CarlosVieira99/Pikasso-Project/README.md

# Pikasso-Project
Bachelor Project with a final classification of 19 (scale of 0 - 20). Drawing and writing machine, controlled via Wi-Fi, with a graphical interface on the computer. Developed with C and Python.
