CarlosVieira99/Pikasso-Project/Datasheets/Stepper Table.jpg

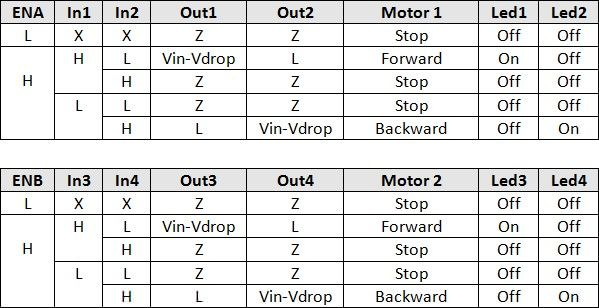
Datasheets/Stepper Table.jpg
