CarlosVieira99/Pikasso-Project/Mechanical Structure/Peças 3D.png

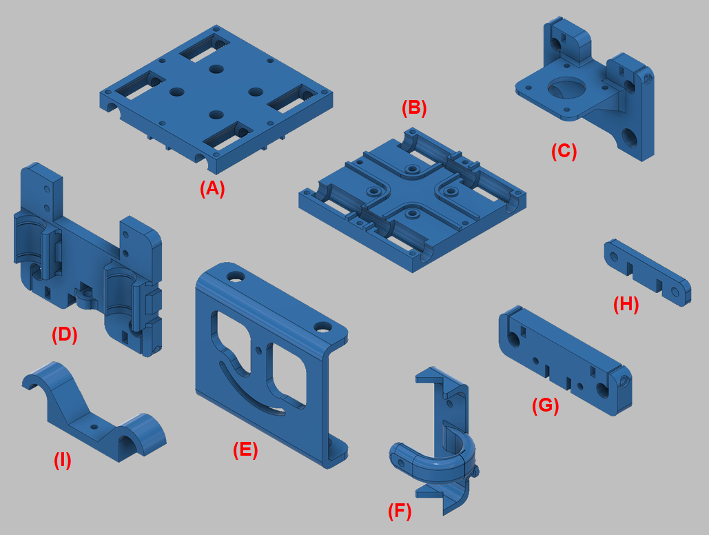
Mechanical Structure/Peças 3D.png
