CarlosVieira99/Pikasso-Project/Mechanical Structure/Projeto final.png

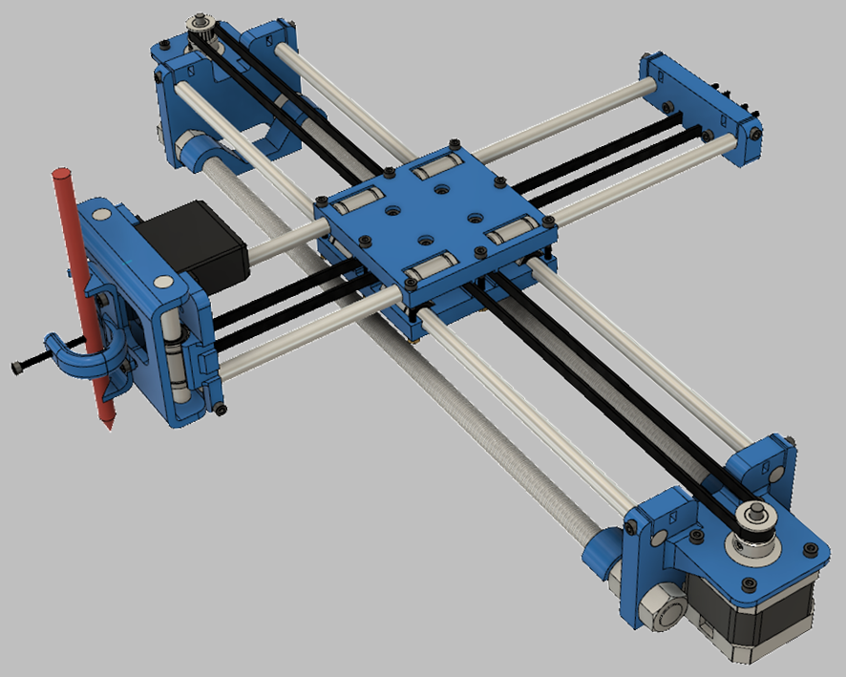
Mechanical Structure/Projeto final.png
