CarlosVieira99/Pikasso-Project/PCB Files/imagens/Vista_Baixo_RayTracing.png

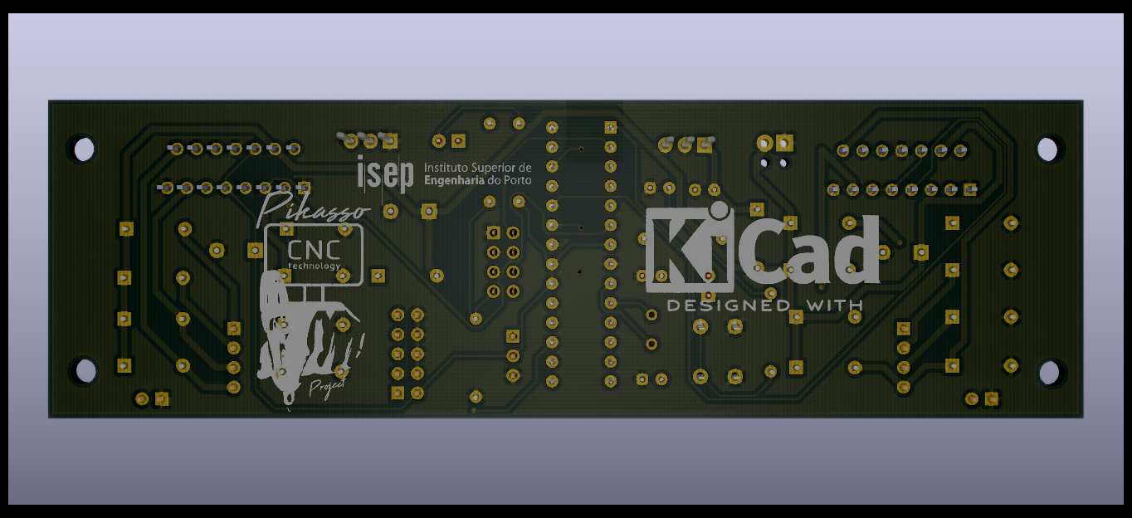
PCB Files/imagens/Vista_Baixo_RayTracing.png
