CarlosVieira99/Pikasso-Project/PCB Files/imagens/Vista_Cima_RayTracing.png

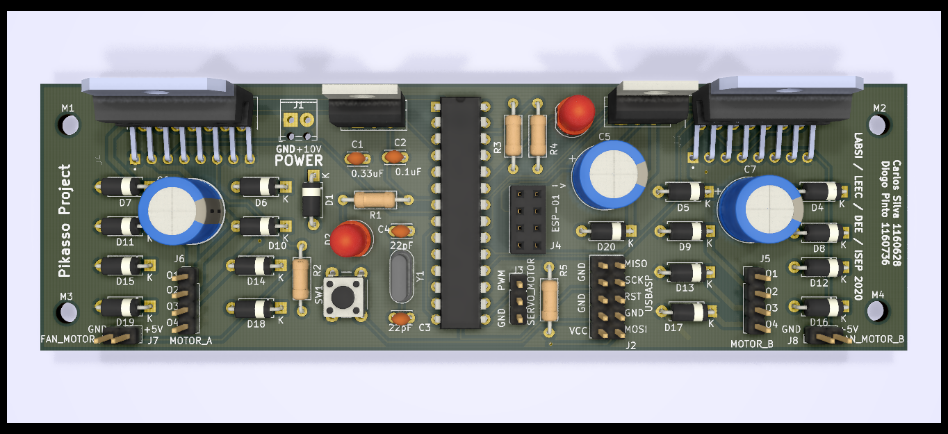
PCB Files/imagens/Vista_Cima_RayTracing.png
