CarlosVieira99/Pikasso-Project/PCB Files/imagens/Vista_Media_RayTracing.png

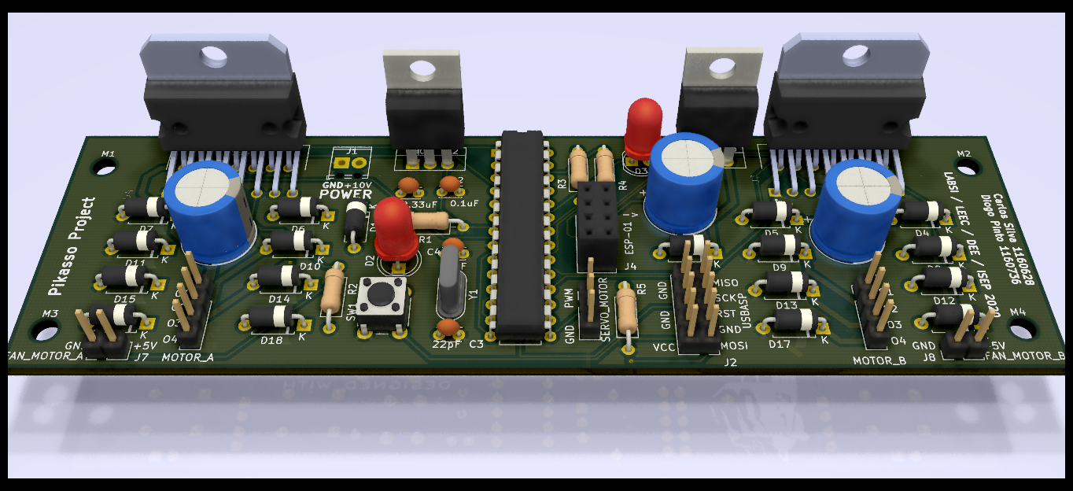
PCB Files/imagens/Vista_Media_RayTracing.png
