CarlosVieira99/Pikasso-Project/Report HTML/ff.jpg

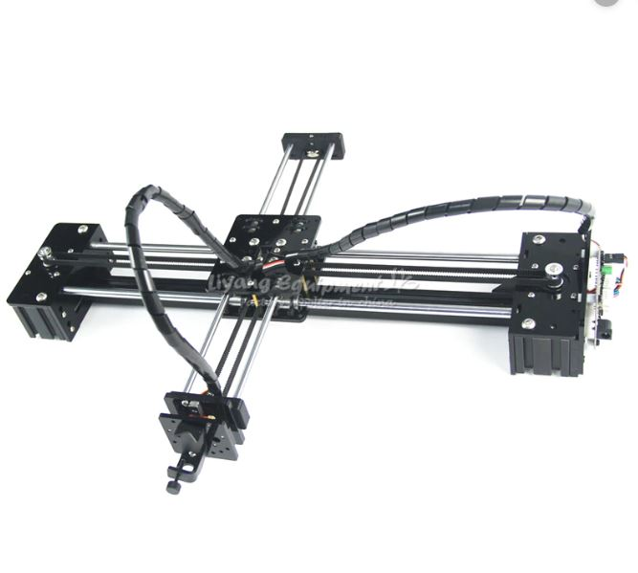
Report HTML/ff.jpg
