CarlosVieira99/Pikasso-Project/Mechanical Structure/Material_1.png

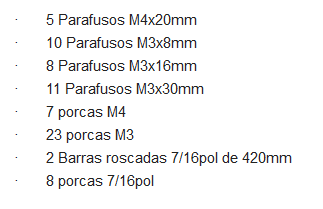
Mechanical Structure/Material_1.png
