CarlosVieira99/Pikasso-Project/Mechanical Structure/Material_2.png

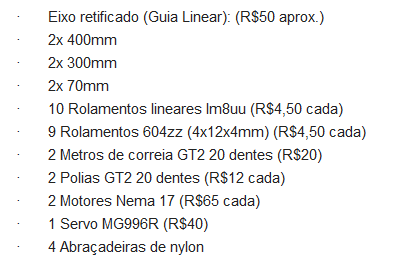
Mechanical Structure/Material_2.png
