CarlosVieira99/Pikasso-Project/Mechanical Structure/Trava_Correia_B.stl

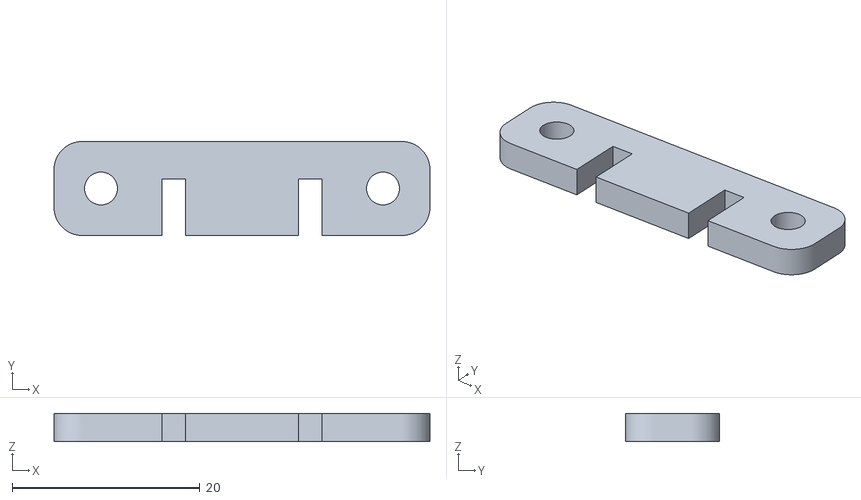
[picture p30: CAD file, 2021-06-29]
Mechanical Structure/Trava_Correia_B.stl
40.0 x 10.0 x 3.00
