CarlosVieira99/Pikasso-Project/Mechanical Structure/Chapa_EixoZ_A.stl

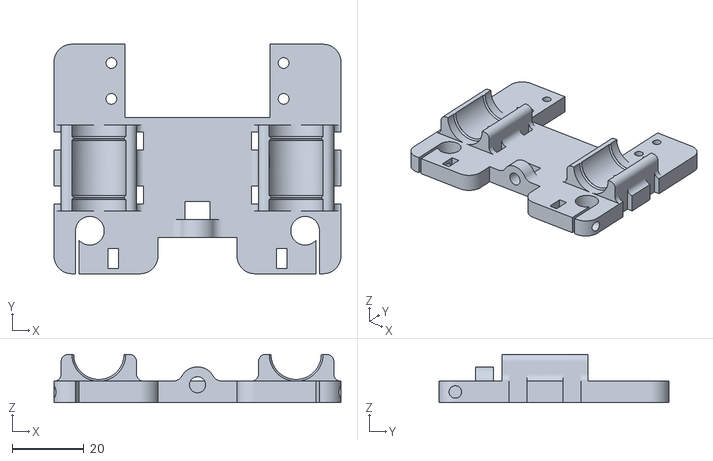
[picture p31: CAD file, 2021-06-29]
Mechanical Structure/Chapa_EixoZ_A.stl
80.0 x 64.0 x 13.5
