CarlosVieira99/Pikasso-Project/Mechanical Structure/Trava_Caneta.stl

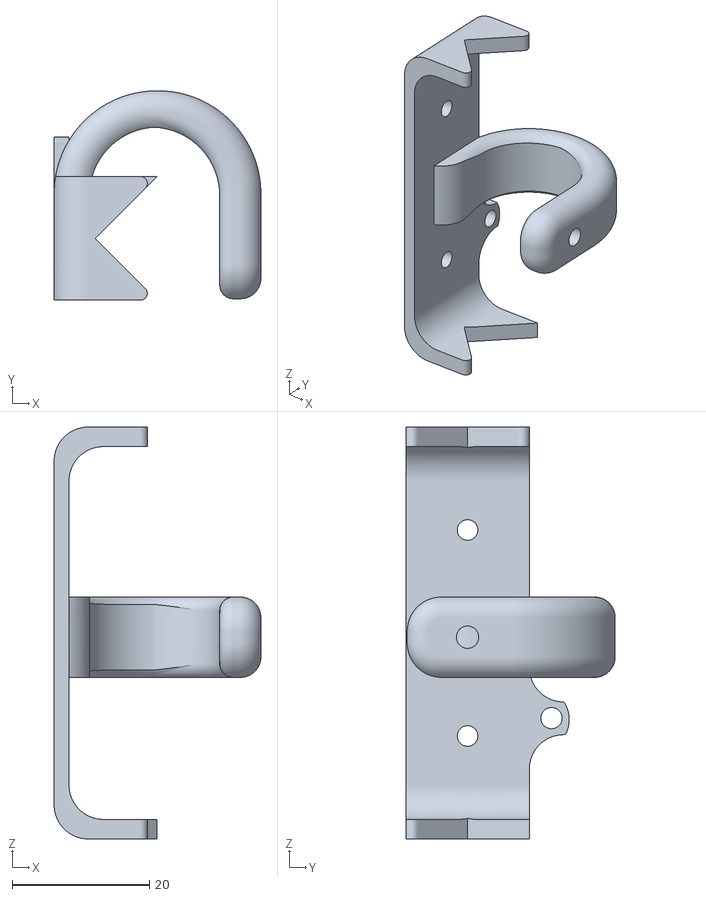
[picture p33: CAD file, 2021-06-29]
Mechanical Structure/Trava_Caneta.stl
30.1 x 30.5 x 60.0
