CarlosVieira99/Pikasso-Project/Mechanical Structure/Chapa_EixoZ_B.stl

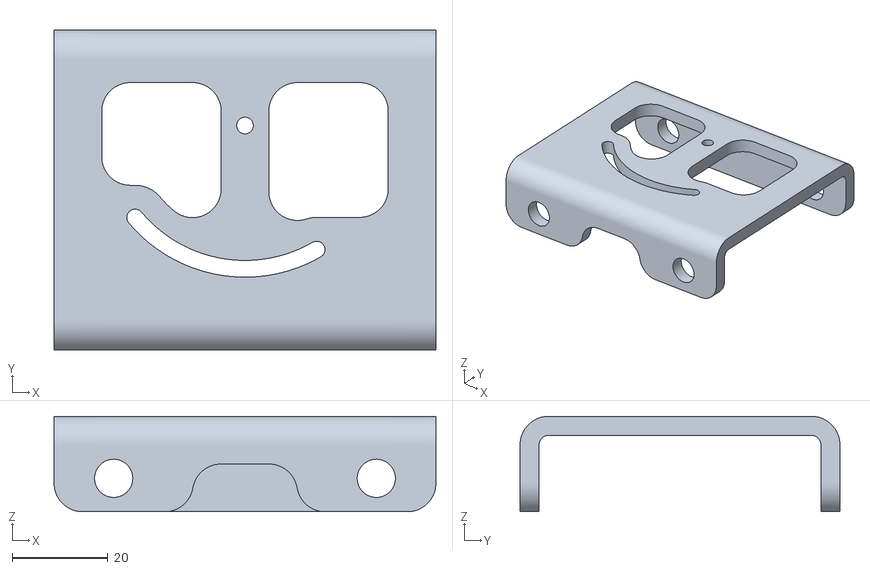
[picture p34: CAD file, 2021-06-29]
Mechanical Structure/Chapa_EixoZ_B.stl
80.0 x 67.0 x 20.0
