CarlosVieira99/Pikasso-Project/Mechanical Structure/Suporte_Motor.stl

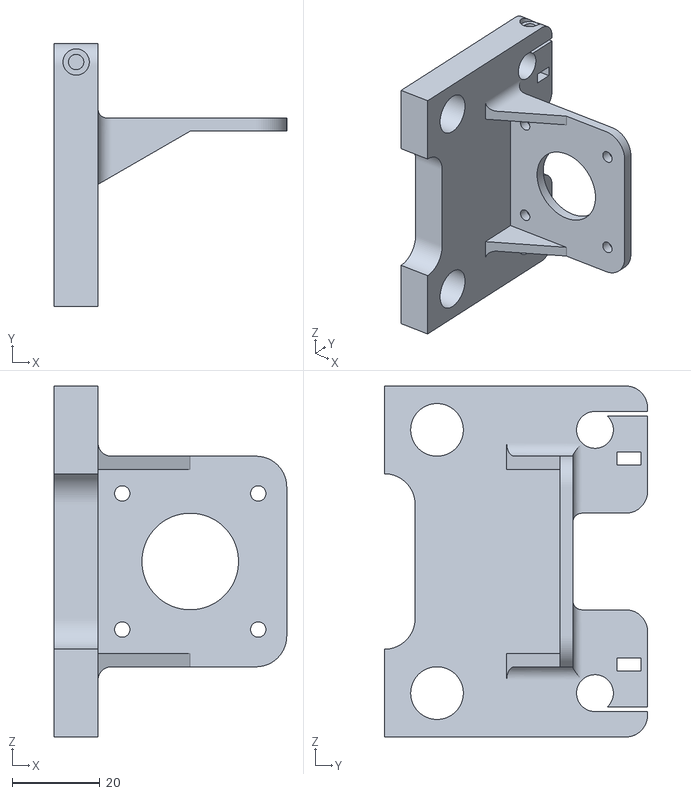
[picture p35: CAD file, 2021-06-29]
Mechanical Structure/Suporte_Motor.stl
53.0 x 60.0 x 80.0
