CarlosVieira99/Pikasso-Project/Mechanical Structure/Chapa_EixoXY_B.stl

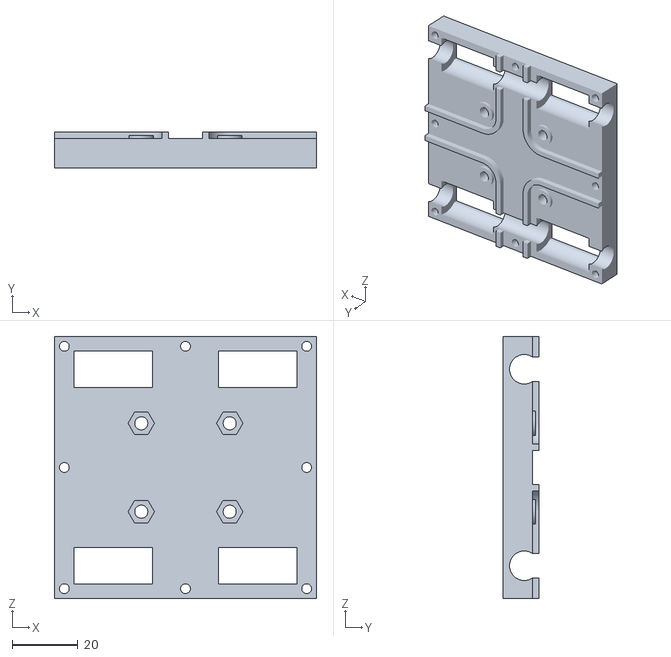
[picture p36: CAD file, 2021-06-29]
Mechanical Structure/Chapa_EixoXY_B.stl
80.0 x 11.0 x 80.0
