CarlosVieira99/Pikasso-Project/Mechanical Structure/Trava_Correia_A.stl

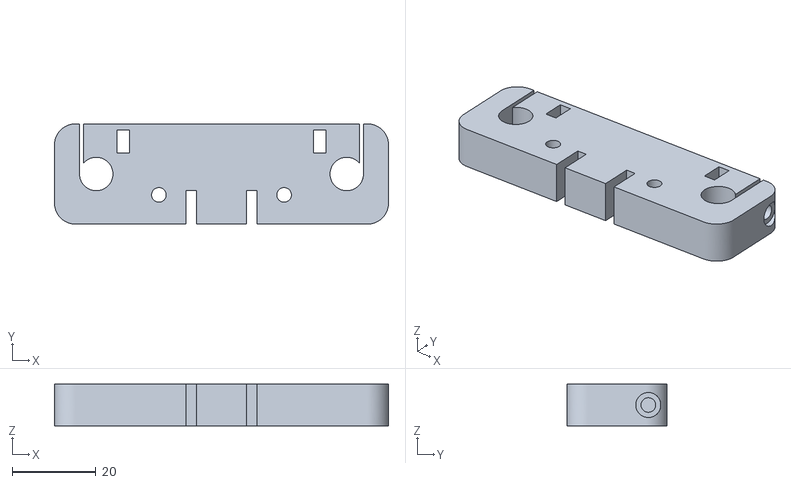
[picture p37: CAD file, 2021-06-29]
Mechanical Structure/Trava_Correia_A.stl
80.0 x 24.0 x 10.0
