CarlosVieira99/Pikasso-Project/Report HTML/fluxograma.pdf

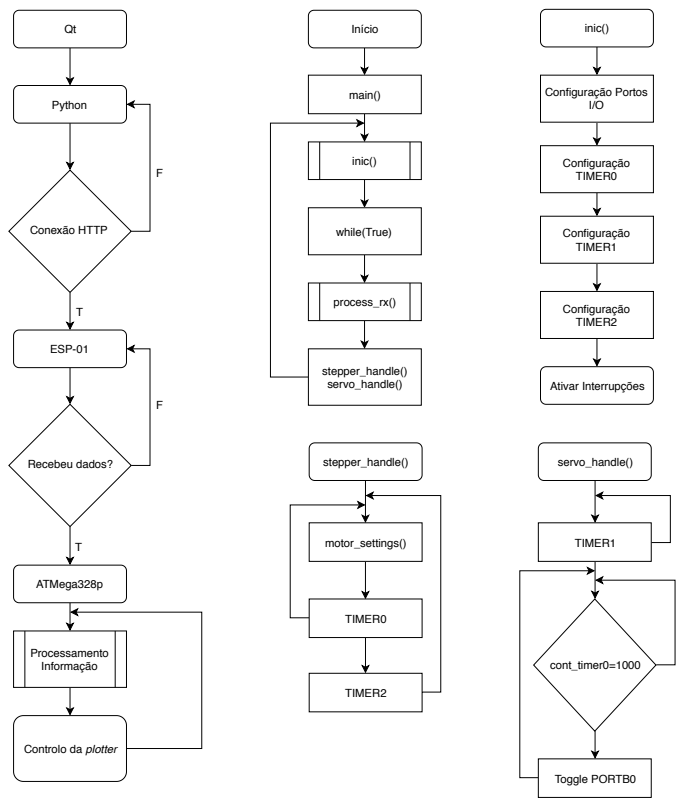
[picture p38: page 1]
Conexão HTTP; Python; ESP-01; ATMega328p; Recebeu dados?; Processamento Informação; Início; inic(); while(True); process_rx(); stepper_handle() servo_handle(); Configuração Portos I/O; Configuração TIMER0; Configuração TIMER1; Configuração TIMER2; Ativar Interrupções; stepper_handle(); servo_handle(); main(); motor_settings(); TIMER0; TIMER2; TIMER1; Toggle PORTB0; cont_timer0=1000

Controlo da plotter
