CarlosVieira99/Pikasso-Project/PCB Files/pdfs/Desenho_Componentes.pdf

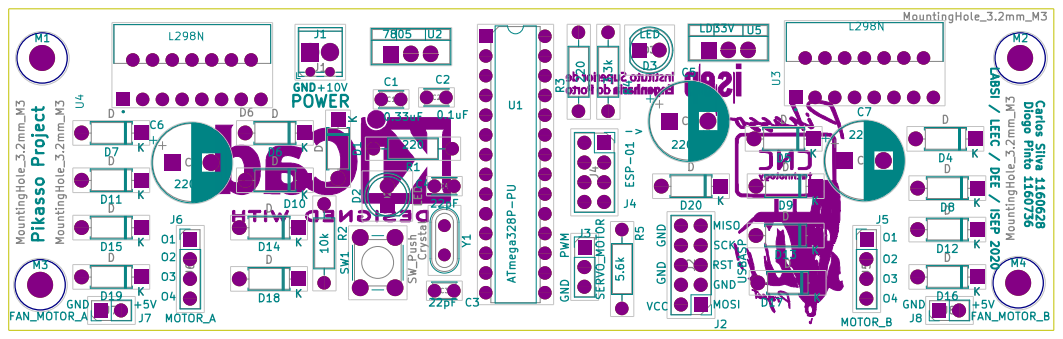
[picture p39: page 1]
