CarlosVieira99/Pikasso-Project/PCB Files/pdfs/Desenho_Componentes_PB.pdf

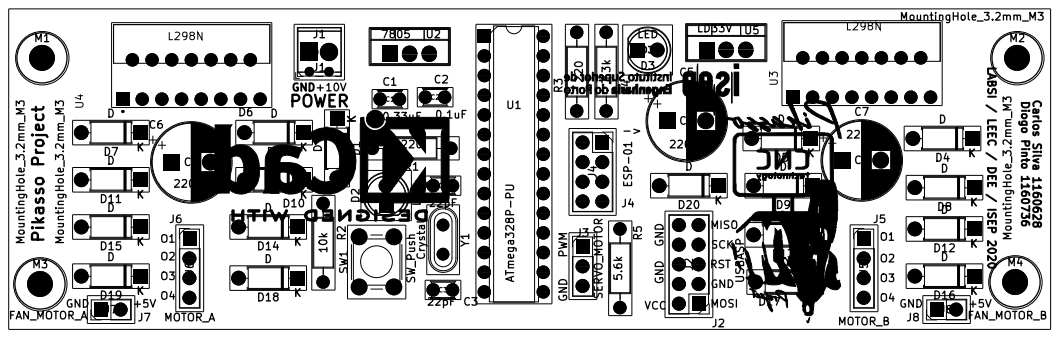
[picture p40: page 1]
