CarlosVieira99/Pikasso-Project/PCB Files/pdfs/Desenho.pdf

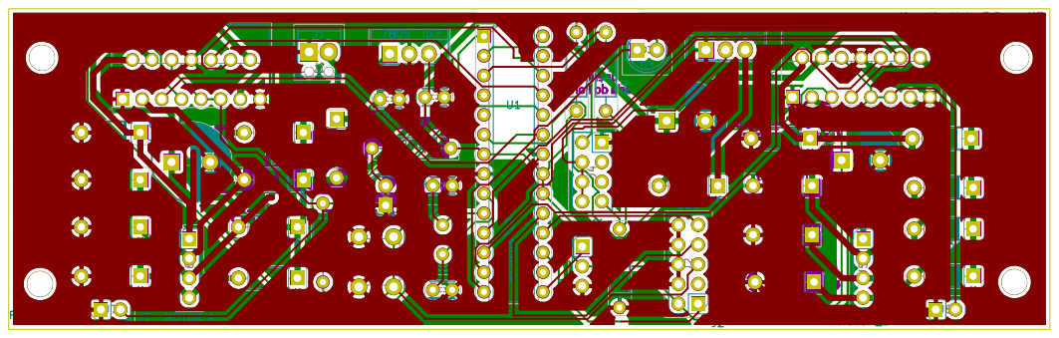
[picture p41: page 1]
