CarlosVieira99/Pikasso-Project/PCB Files/pdfs/Desenho_Frente.pdf

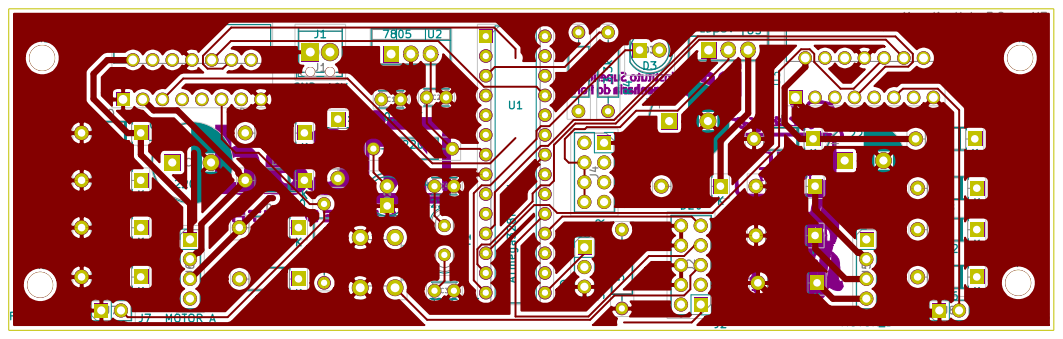
[picture p42: page 1]
