CarlosVieira99/Pikasso-Project/PCB Files/pdfs/Desenho_Frente_PB.pdf

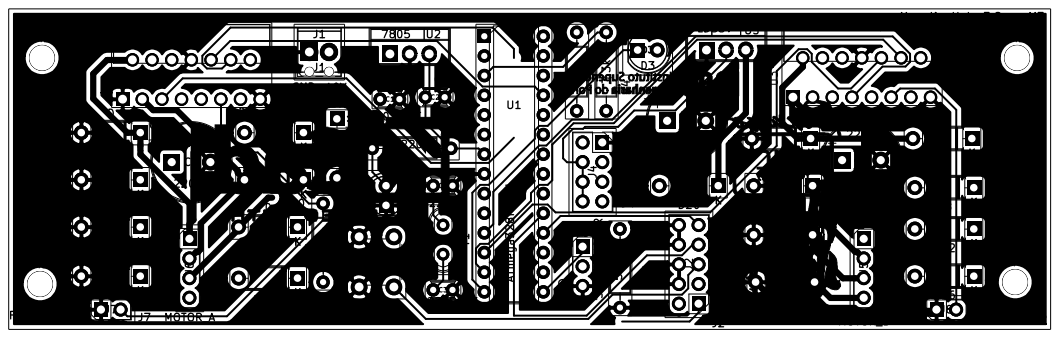
[picture p43: page 1]
