CarlosVieira99/Pikasso-Project/PCB Files/pdfs/Desenho_PB.pdf

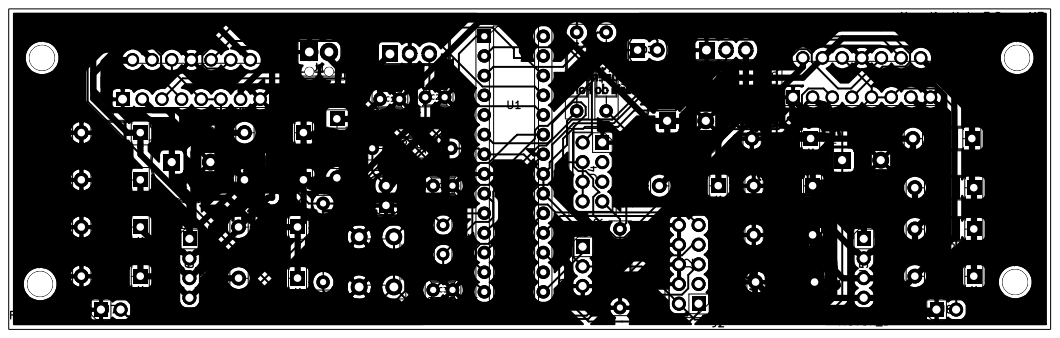
[picture p44: page 1]
