CarlosVieira99/Pikasso-Project/PCB Files/pdfs/Desenho_Tras.pdf

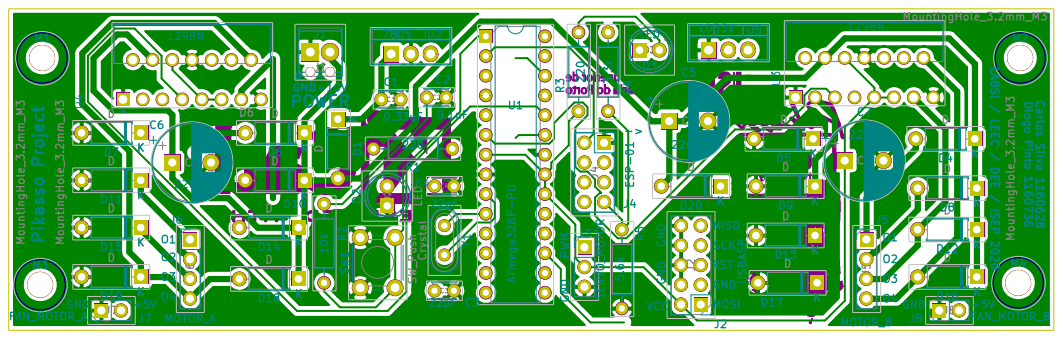
[picture p45: page 1]
