CarlosVieira99/Pikasso-Project/PCB Files/pdfs/Desenho_Tras_PB.pdf

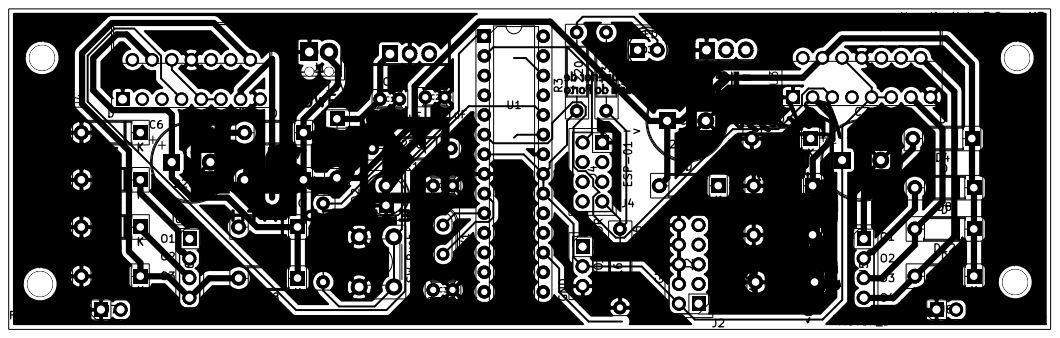
[picture p46: page 1]
