CarlosVieira99/Pikasso-Project/PCB Files/pdfs/Esquematico_PB.pdf

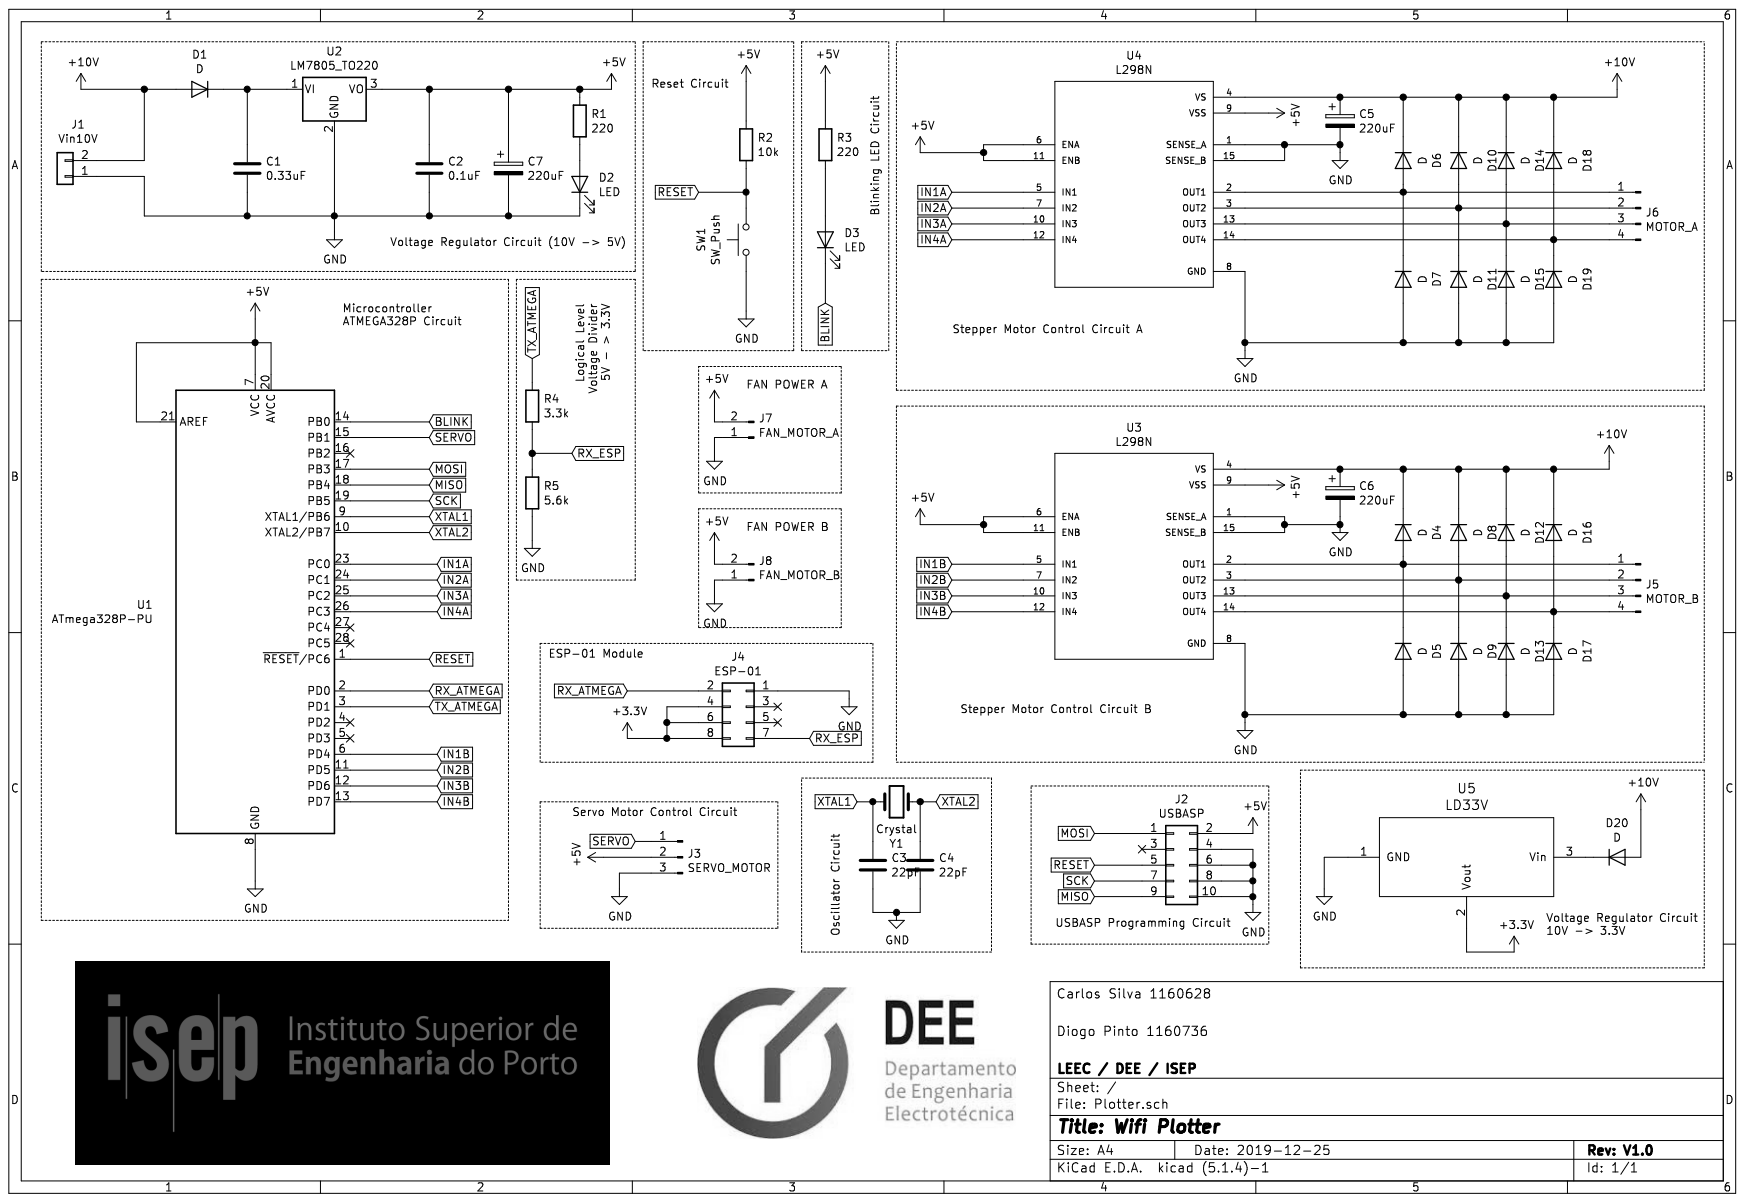
[picture p47: page 1]
