CarlosVieira99/Pikasso-Project/PCB Files/pdfs/Esquematico.pdf

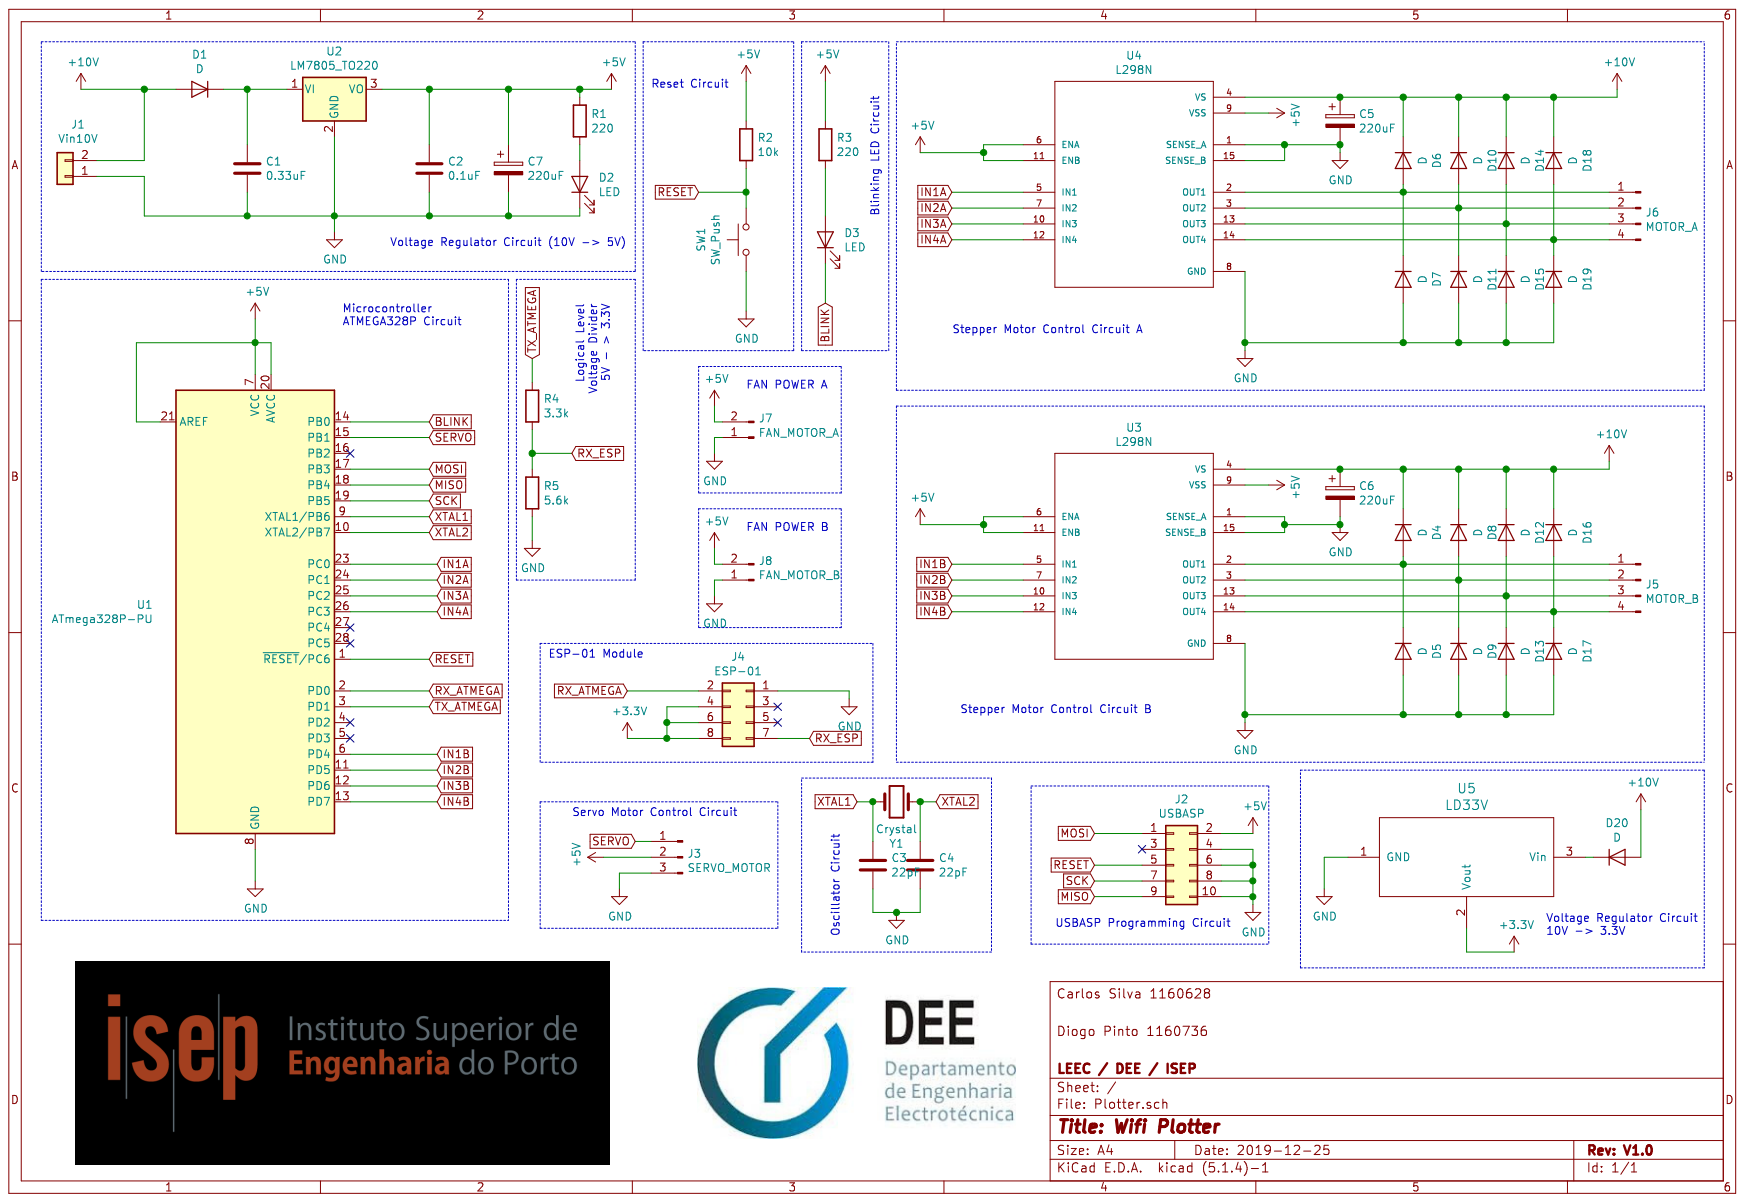
[picture p48: page 1]
