CarlosVieira99/Pikasso-Project/(list of files, drawings)

Other design files:
Proteus Simulation/Plotter.pdsprj
