CarlosVieira99/Pikasso-Project/PCB Files/Plotter.kicad_pcb

## KiCad design PCB Files/Plotter.kicad_pcb (2021-06-29)

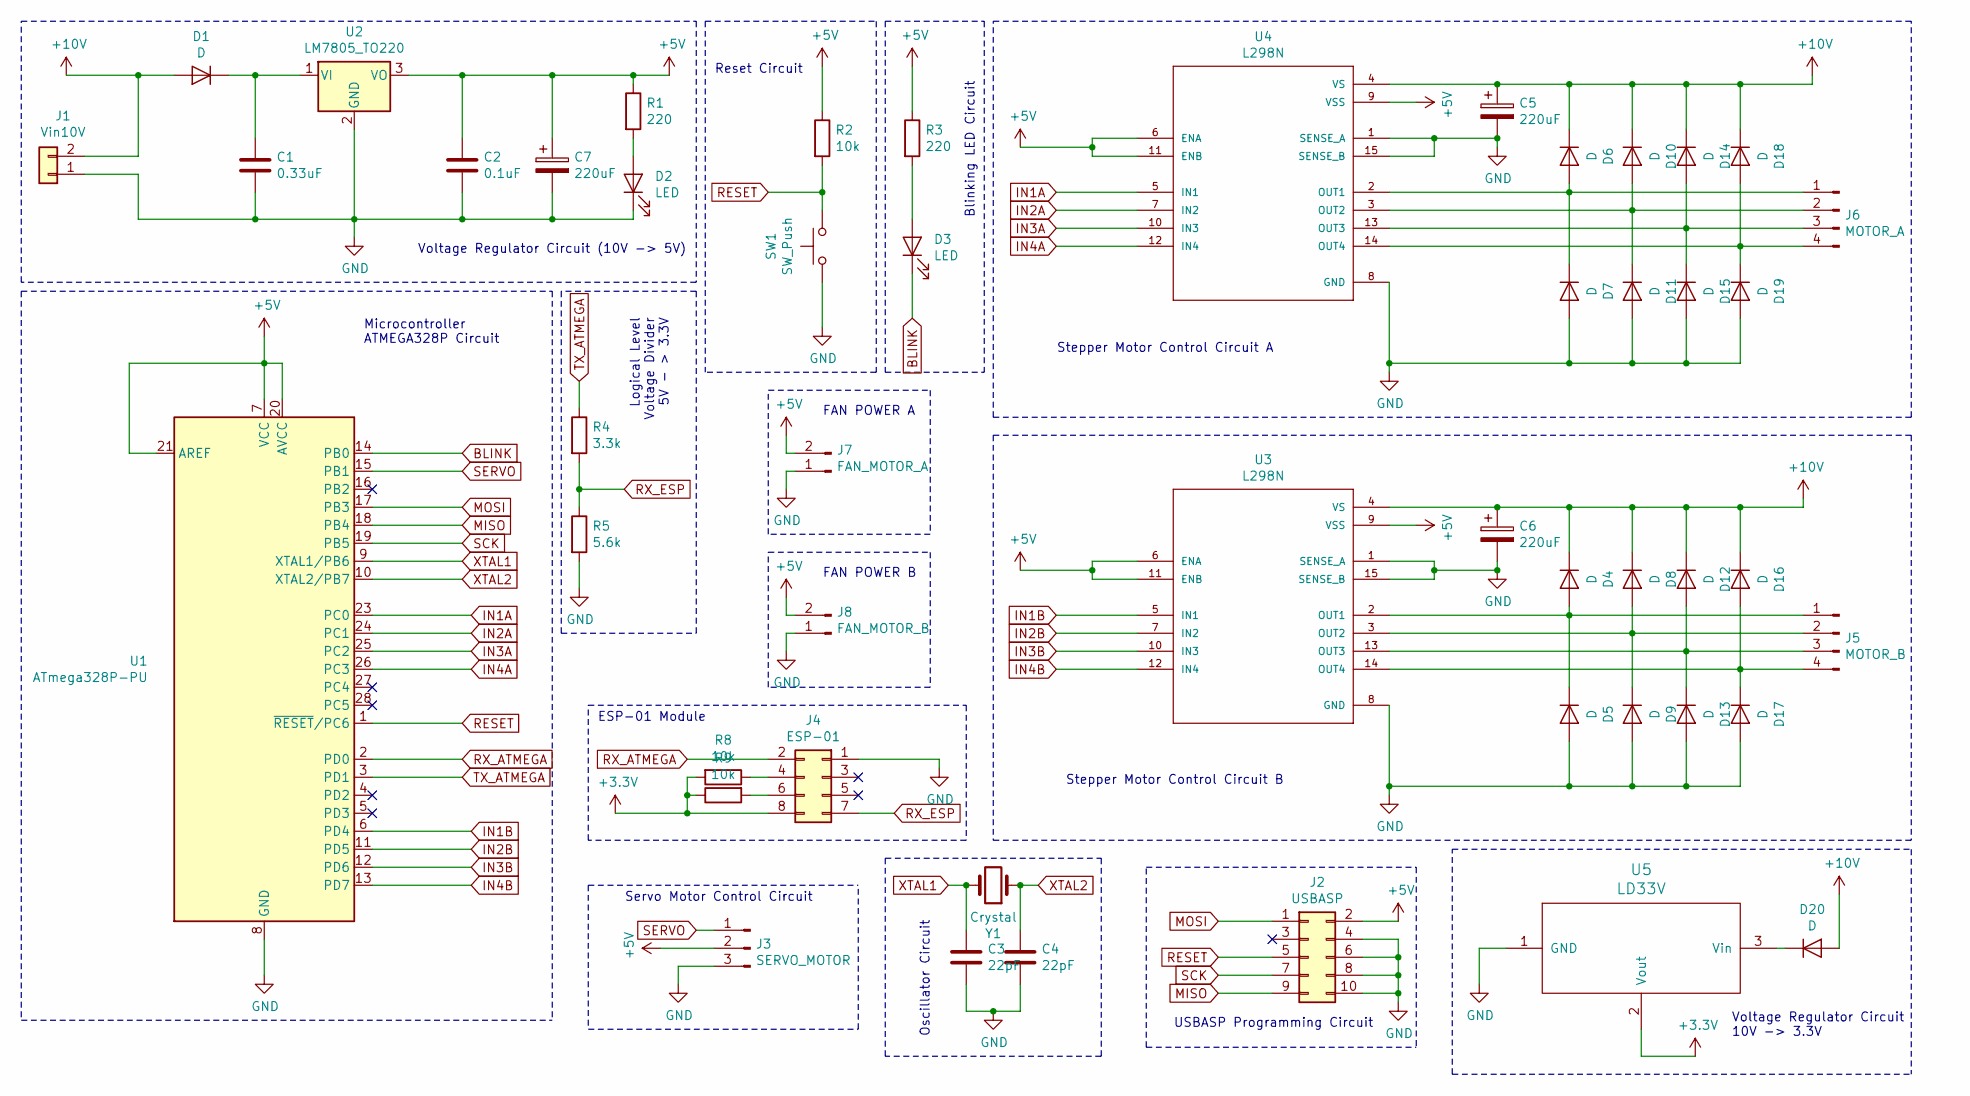
[picture p49: schematic Plotter.sch, Wifi Plotter]

Parts:
C1: 0.33uF; C_Disc_D3.0mm_W2.0mm_P2.50mm
C2: 0.1uF; C_Disc_D3.0mm_W2.0mm_P2.50mm
C3, C4: 22pF; C_Disc_D3.0mm_W2.0mm_P2.50mm
C5, C6, C7: 220uF; CP_Radial_D10.0mm_P5.00mm
D1, D4, D5, D6, D7, D8, D9, D10, D11, D12, D13, D14, D15, D16, D17, D18, D19, D20: D; D_A-405_P7.62mm_Horizontal
D2, D3: LED; LED_D5.0mm
J1: Vin10V; TerminalBlock_Phoenix_MPT-2.54mm_2pol
J2: USBASP; PinHeader_2x05_P2.54mm_Vertical
J3: SERVO_MOTOR; PinHeader_1x03_P2.54mm_Vertical
J4: ESP-01; PinSocket_2x04_P2.54mm_Vertical
J5: MOTOR_B; PinHeader_1x04_P2.54mm_Vertical
J6: MOTOR_A; PinHeader_1x04_P2.54mm_Vertical
J7: FAN_MOTOR_A; PinHeader_1x02_P2.54mm_Vertical
J8: FAN_MOTOR_B; PinHeader_1x02_P2.54mm_Vertical
R1, R3: 220; R_Axial_DIN0207_L6.3mm_D2.5mm_P10.16mm_Horizontal
R2, R8, R9: 10k; R_Axial_DIN0207_L6.3mm_D2.5mm_P10.16mm_Horizontal
R4: 3.3k; R_Axial_DIN0207_L6.3mm_D2.5mm_P10.16mm_Horizontal
R5: 5.6k; R_Axial_DIN0207_L6.3mm_D2.5mm_P10.16mm_Horizontal
SW1: SW_Push; SW_PUSH_6mm
U1: ATmega328P-PU; DIP-28_W7.62mm
U2: LM7805_TO220; TO-220-3_Vertical
U3, U4: L298N; TO127P2020X500X2100-15
U5: LD33V; TO-220-3_Vertical
Y1: Crystal; Crystal_HC52-6mm_Vertical

Connections:
+3V3: J4.8, R8.2, R9.1, U5.2 (Vout); also elsewhere on the board
+5V: C2.1, C7.1, J2.2, J3.2, J7.2, J8.2, R1.1, R2.1, R3.1, U1.7 (VCC), U1.20 (AVCC), U1.21 (AREF), U2.3 (VO), U3.6 (ENA), U3.9 (VSS), U3.11 (ENB), U4.6 (ENA), U4.9 (VSS), U4.11 (ENB)
+10V: C5.1, C6.1, D1.2 (A), D4.1 (K), D6.1 (K), D8.1 (K), D10.1 (K), D12.1 (K), D14.1 (K), D16.1 (K), D18.1 (K), D20.2 (A), J1.2, U3.4 (VS), U4.4 (VS)
BLINK: D3.1 (K), U1.14 (PB0)
GND: C1.2, C2.2, C3.2, C4.2, C5.2, C6.2, C7.2, D2.1 (K), D5.2 (A), D7.2 (A), D9.2 (A), D11.2 (A), D13.2 (A), D15.2 (A), D17.2 (A), D19.2 (A), J1.1, J2.4, J2.6, J2.8, J2.10, J3.3, J4.1, J7.1, J8.1, R5.2, SW1.1, U1.8 (GND), U1.22 (GND), U2.2 (GND), U3.1 (SENSE_A), U3.8 (GND), U3.15 (SENSE_B), U4.1 (SENSE_A), U4.8 (GND), U4.15 (SENSE_B), U5.1 (GND)
IN1A: U1.23 (PC0), U4.5 (IN1)
IN1B: U1.6 (PD4), U3.5 (IN1)
IN2A: U1.24 (PC1), U4.7 (IN2)
IN2B: U1.11 (PD5), U3.7 (IN2)
IN3A: U1.25 (PC2), U4.10 (IN3)
IN3B: U1.12 (PD6), U3.10 (IN3)
IN4A: U1.26 (PC3), U4.12 (IN4)
IN4B: U1.13 (PD7), U3.12 (IN4)
MISO: J2.9, U1.18 (PB4)
MOSI: J2.1, U1.17 (PB3)
unnamed: C1.1, D1.1 (K), U2.1 (VI)
unnamed: D2.2 (A), R1.2
unnamed: D3.2 (A), R3.2
unnamed: D4.2 (A), D5.1 (K), J5.1, U3.2 (OUT1)
unnamed: D6.2 (A), D7.1 (K), J6.1, U4.2 (OUT1)
unnamed: D8.2 (A), D9.1 (K), J5.2, U3.3 (OUT2)
unnamed: D10.2 (A), D11.1 (K), J6.2, U4.3 (OUT2)
unnamed: D12.2 (A), D13.1 (K), J5.3, U3.13 (OUT3)
unnamed: D14.2 (A), D15.1 (K), J6.3, U4.13 (OUT3)
unnamed: D16.2 (A), D17.1 (K), J5.4, U3.14 (OUT4)
unnamed: D18.2 (A), D19.1 (K), J6.4, U4.14 (OUT4)
unnamed: D20.1 (K), U5.3 (Vin)
unnamed 29: J4.4, R8.1; also elsewhere on the board
unnamed 31: J4.6, R9.2; also elsewhere on the board
RESET: J2.5, R2.2, SW1.2, U1.1 (~RESET~/PC6)
RX_ATMEGA: J4.2, U1.2 (PD0)
RX_ESP: J4.7, R4.2, R5.1
SCK: J2.7, U1.19 (PB5)
SERVO: J3.1, U1.15 (PB1)
TX_ATMEGA: R4.1, U1.3 (PD1)
XTAL1: C3.1, U1.9 (XTAL1/PB6), Y1.2
XTAL2: C4.1, U1.10 (XTAL2/PB7), Y1.1

Notes on the sheet:
ESP-01 Module
Reset Circuit
Stepper Motor Control Circuit A
Voltage Regulator Circuit (10V -> 5V)
USBASP Programming Circuit
Servo Motor Control Circuit
Microcontroller ATMEGA328P Circuit
Stepper Motor Control Circuit B
Logical Level Voltage Divider 5V - > 3.3V
Voltage Regulator Circuit 10V -> 3.3V
Oscillator Circuit
Blinking LED Circuit
FAN POWER A
FAN POWER B

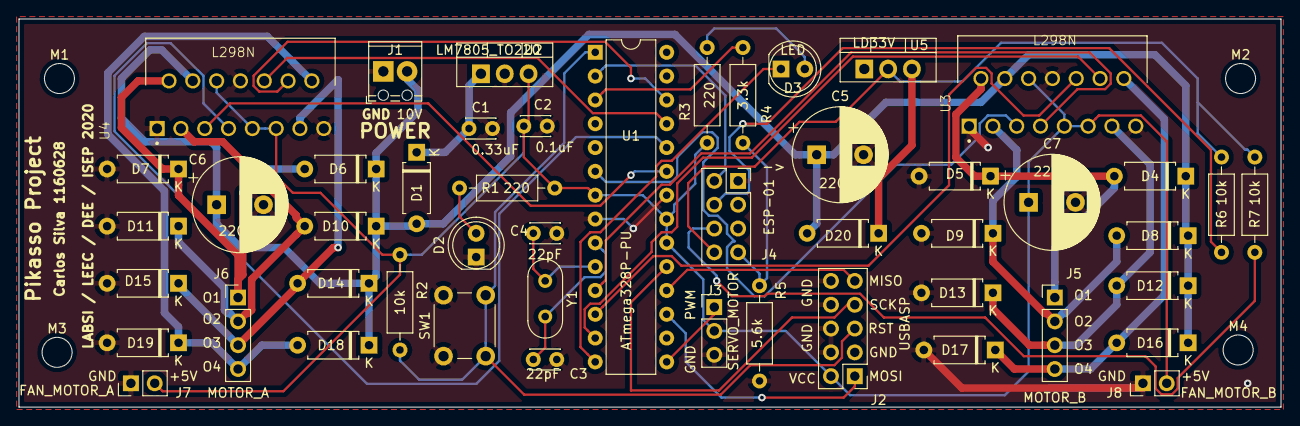
[picture p50: board Plotter.kicad_pcb from above]

Board: 2 copper layers, 134.6 x 41.4 mm, 53 parts (0 on the bottom side), 37 nets.

Other parts of the board:
M1, M2, M3, M4: MountingHole_3.2mm_M3
R6, R7: 10k; R_Axial_DIN0207_L6.3mm_D2.5mm_P10.16mm_Horizontal

Their connections:
+3V3: R6.2, R7.2; also elsewhere on the board
unnamed 29: R6.1; also elsewhere on the board
unnamed 31: R7.1; also elsewhere on the board
